reifsnyderb/Atari-1090XL-R10/1090.kicad_pcb

## KiCad design 1090.kicad_pcb (2024-02-07)

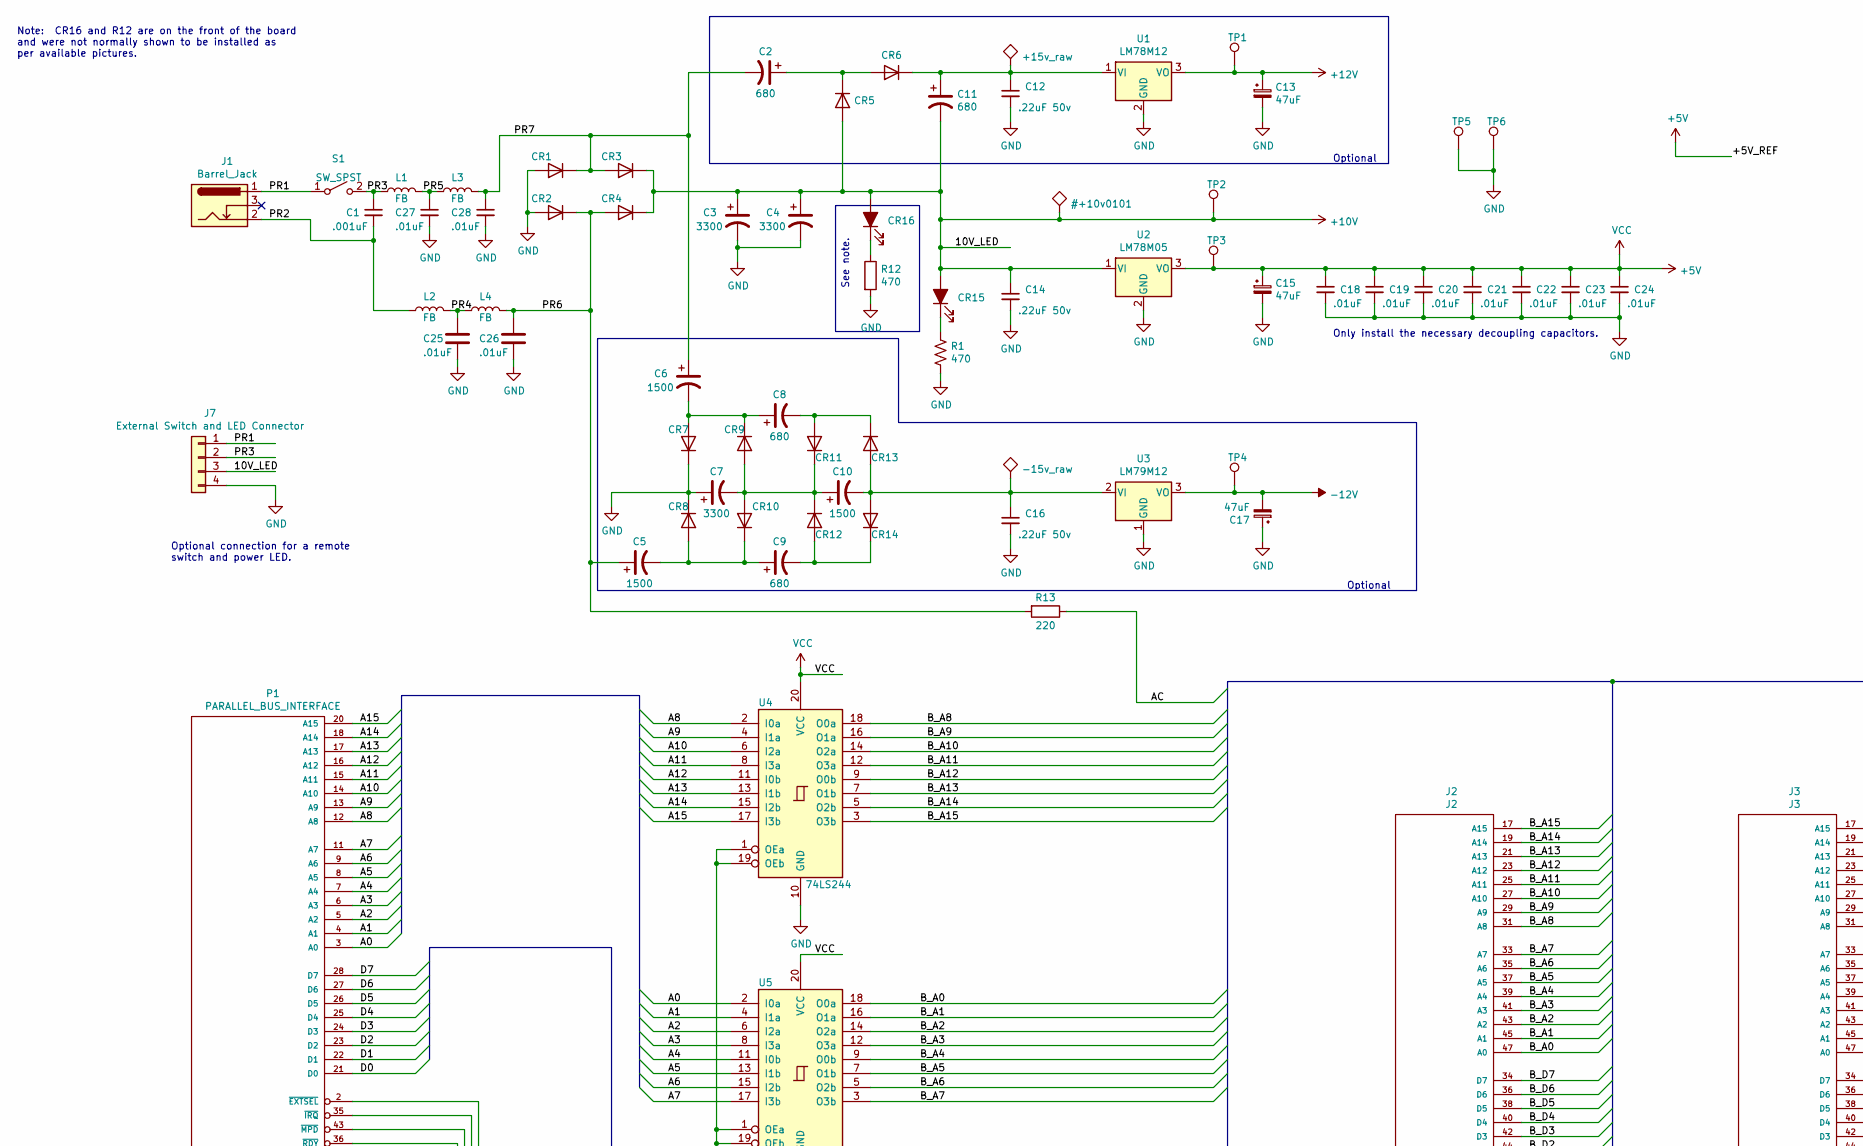
[picture p1: schematic 1090.kicad_sch, 1090 original, part in row 1, column 1]

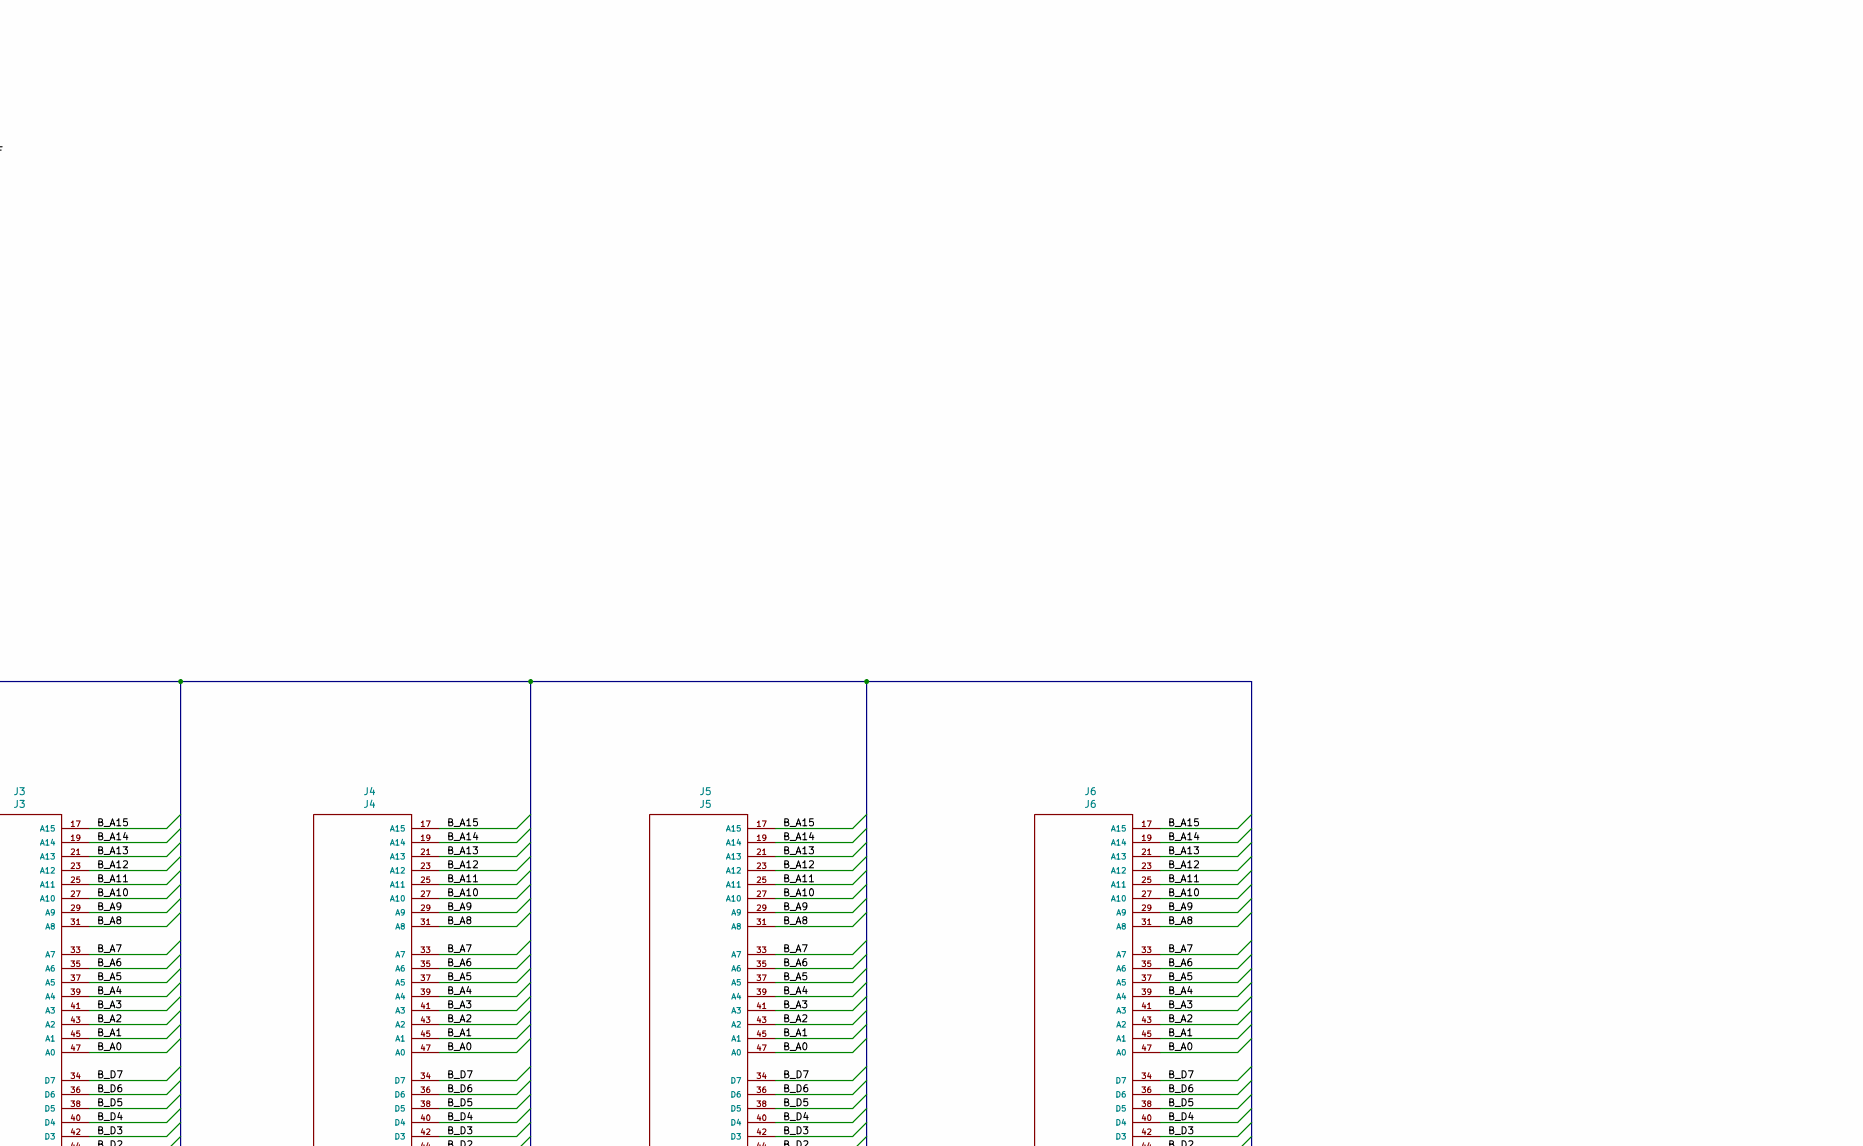
[picture p2: schematic 1090.kicad_sch, 1090 original, part in row 1, column 2]

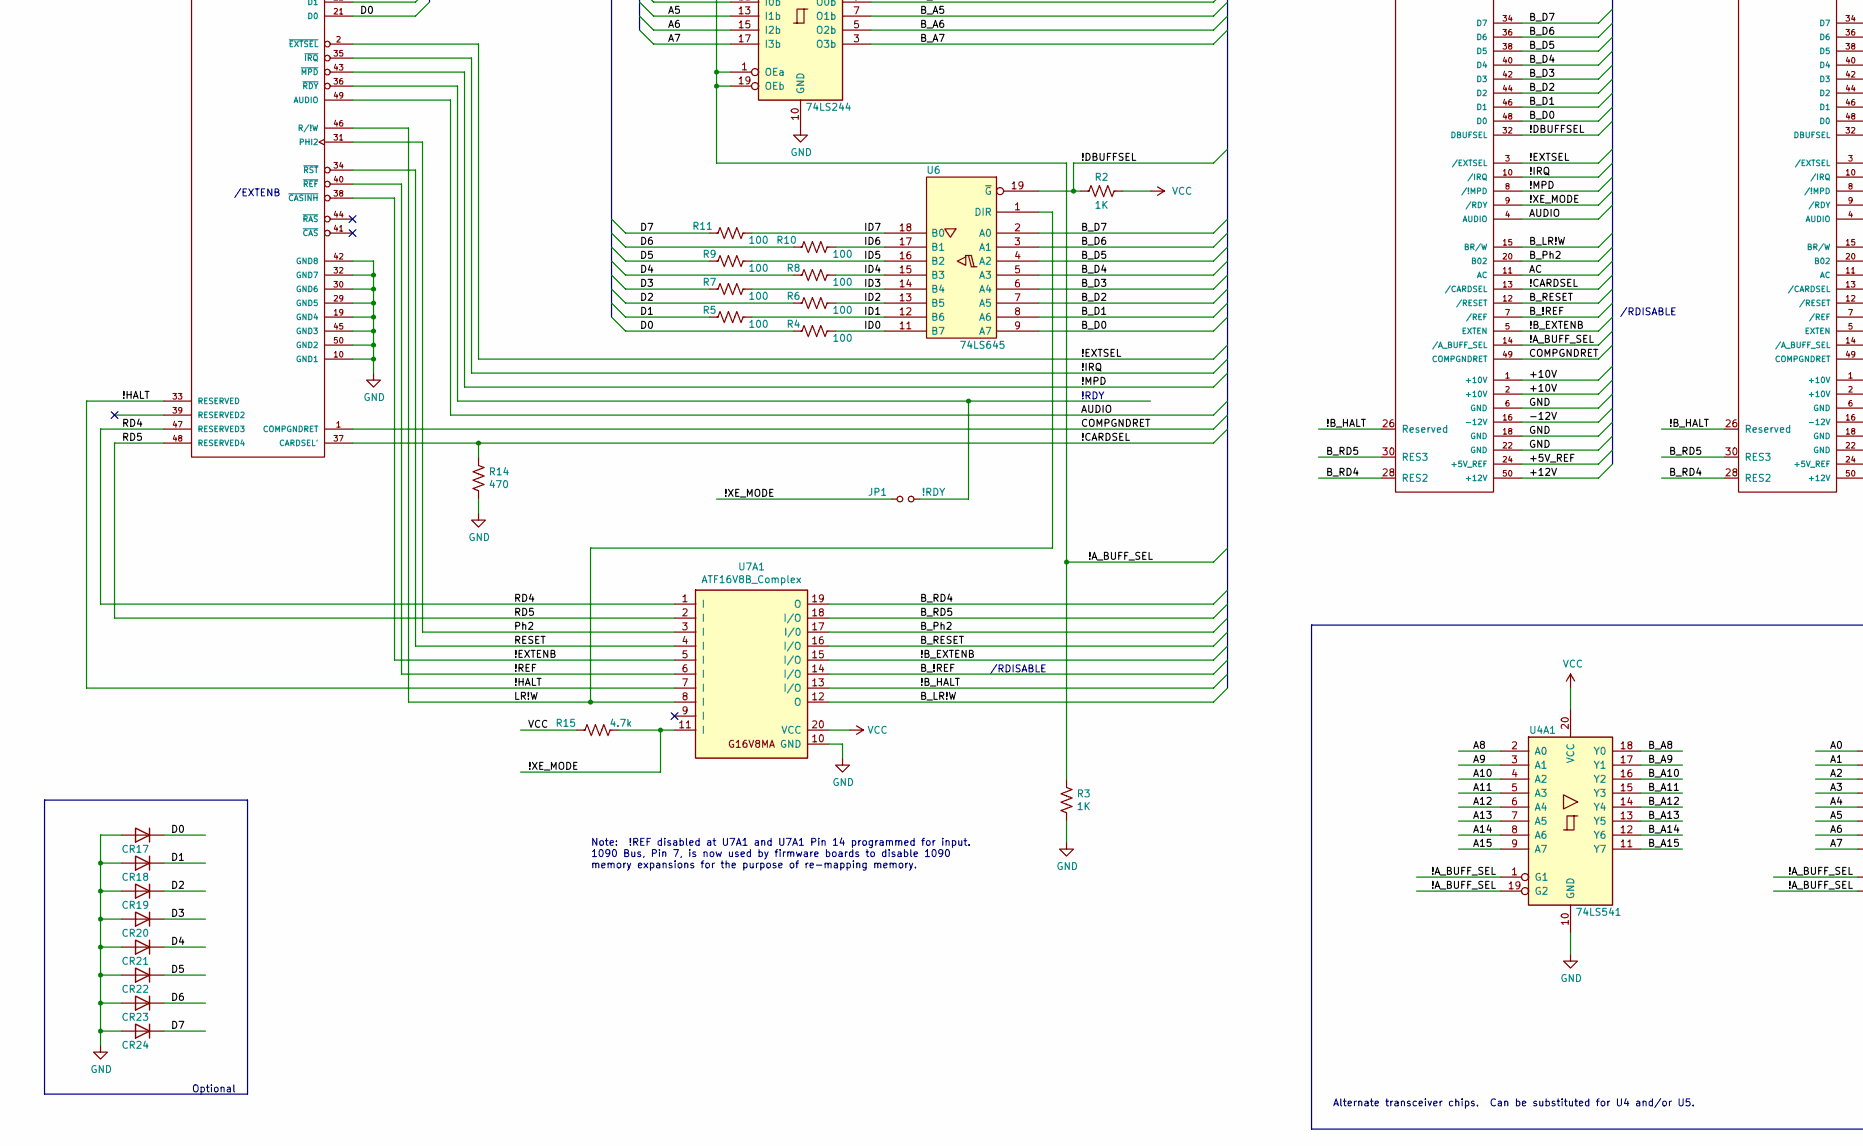
[picture p3: schematic 1090.kicad_sch, 1090 original, part in row 2, column 1]

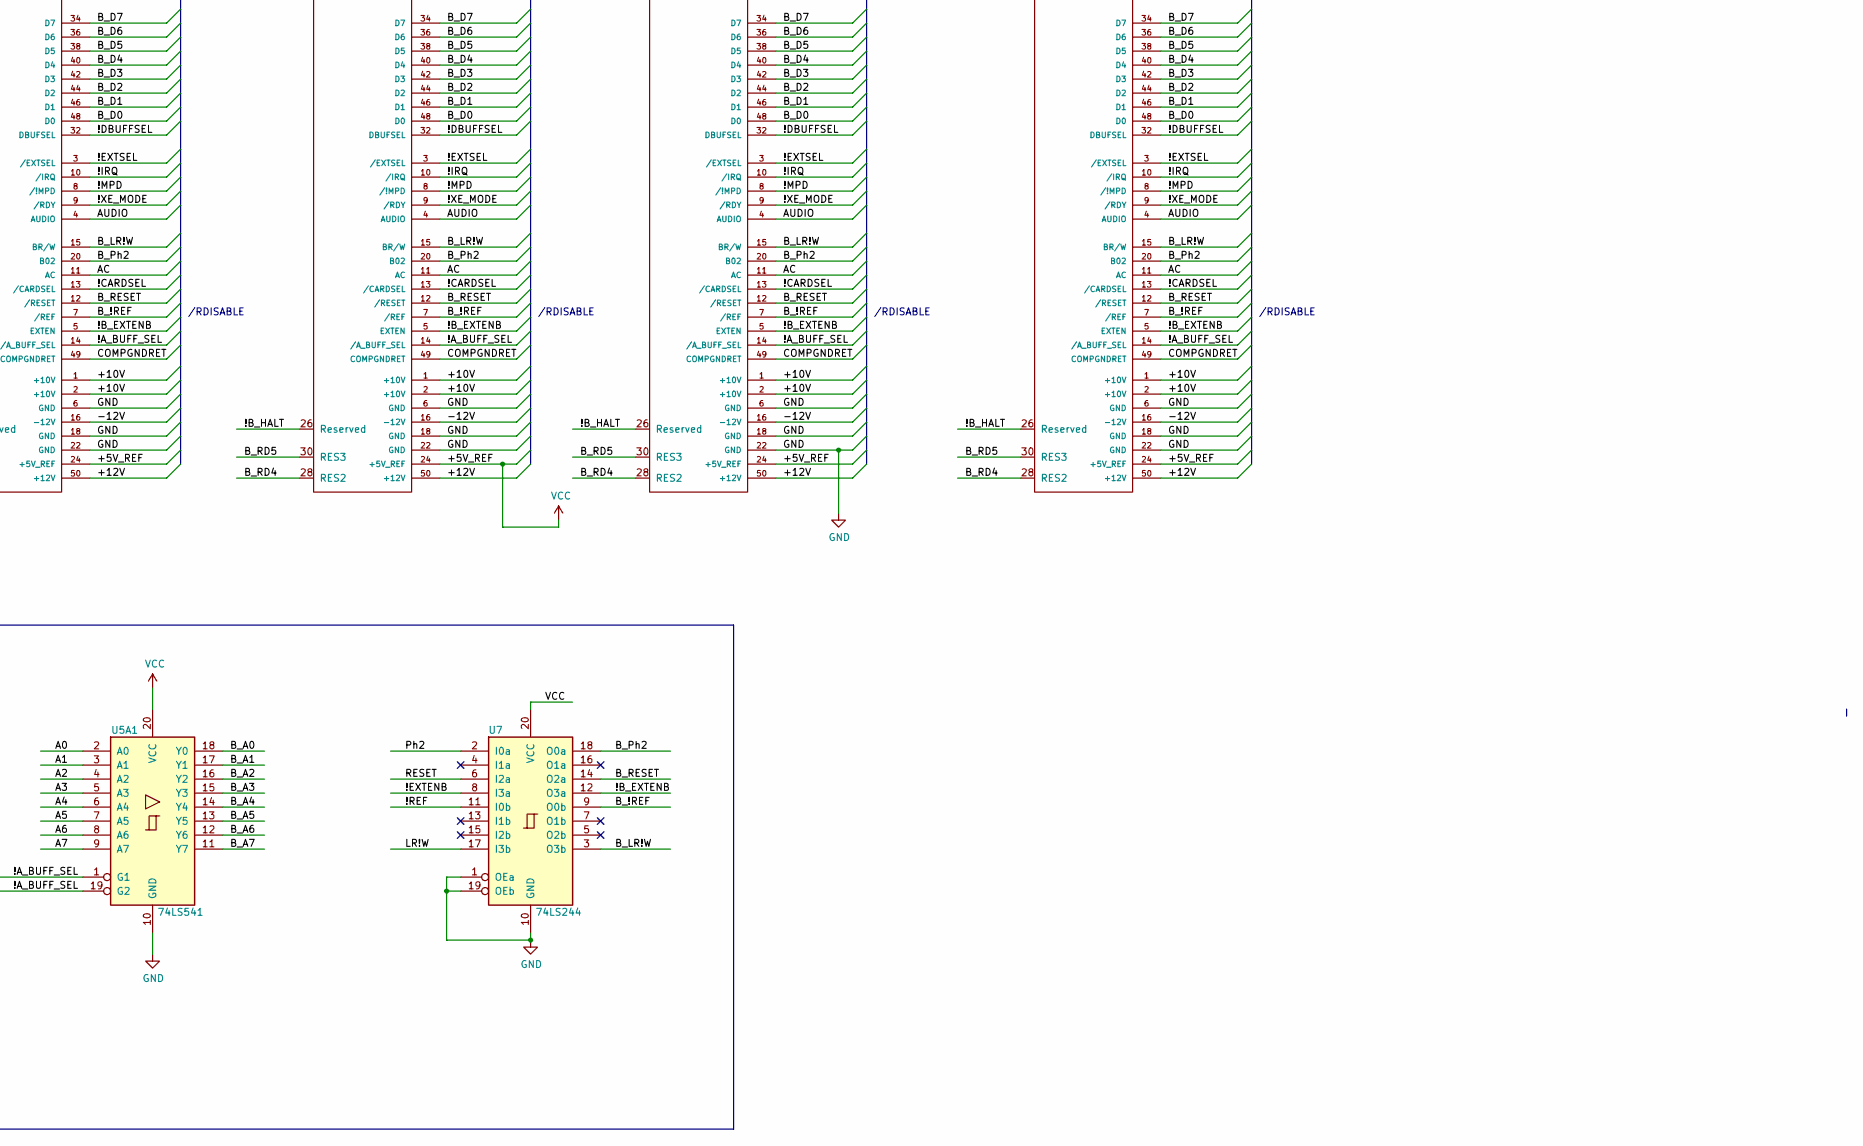
[picture p4: schematic 1090.kicad_sch, 1090 original, part in row 2, column 2]

Parts:
C1: .001uF; C_Axial_L5.1mm_D3.1mm_P12.50mm_Horizontal
C2, C8, C9, C11: 680; CP_Radial_D12.5mm_P5.00mm
C3, C4, C7: 3300; CP_Radial_D22.0mm_P7.50_10.00mm_SnapIn
C5, C6: 1500; CP_Radial_D13.0mm_P7.50mm
C10: 1500; CP_Radial_D16.0mm_P7.50mm
C12, C14: .22uF 50v; C_Axial_L5.1mm_D3.1mm_P15.00mm_Horizontal
C13, C15, C17: 47uF; CP_Radial_D8.0mm_P2.50mm
C16: .22uF 50v; C_Axial_L5.1mm_D3.1mm_P12.50mm_Horizontal
C18, C19, C20, C21, C22, C23, C24, C25, C26, C27, C28: .01uF; C_Axial_L5.1mm_D3.1mm_P12.50mm_Horizontal
CR1, CR2, CR3, CR4: D; D_5KP_P10.16mm_Horizontal
CR5, CR6, CR7, CR8, CR9, CR10, CR11, CR12, CR13, CR14, CR17, CR18, CR19, CR20, CR21, CR22, CR23, CR24: D; D_Axial_L5.1mm_D3.1mm_P12.50mm_Horizontal
CR15, CR16: LED_ALT; LED_D5.0mm_FlatTop
J1: Barrel_Jack; BarrelJack_Wuerth_6941xx301002
J2: J2; AtariSocket_2x25_P2.54mm_Vertical
J3: J3; AtariSocket_2x25_P2.54mm_Vertical
J4: J4; AtariSocket_2x25_P2.54mm_Vertical
J5: J5; AtariSocket_2x25_P2.54mm_Vertical
J6: J6; AtariSocket_2x25_P2.54mm_Vertical
J7: External Switch and LED Connector; Molex_KK-396_A-41791-0004_1x04_P3.96mm_Vertical
JP1: !RDY; PinHeader_1x02_P2.54mm_Vertical
L1, L2, L3, L4: FB; L_Axial_L5.1mm_D3.1mm_P12.50mm_Horizontal
P1: PARALLEL_BUS_INTERFACE; Edge-50
R1, R12, R14: 470; R_Axial_L5.1mm_D3.1mm_P12.50mm_Horizontal
R2, R3: 1K; R_Axial_L5.1mm_D3.1mm_P12.50mm_Horizontal
R4, R5, R6, R7, R8, R9, R10, R11: 100; R_Axial_L5.1mm_D3.1mm_P12.50mm_Horizontal
R13: 220; R_Axial_L5.1mm_D3.1mm_P12.50mm_Horizontal
R15: 4.7k; R_Axial_L5.1mm_D3.1mm_P12.50mm_Horizontal
S1: SW_SPST; E101J1ABE2; Part # E101J1AQE2
TP1: +12V; Pin_D1.0mm_L10.0mm
TP2: +10V; Pin_D1.0mm_L10.0mm
TP3: TestPoint; Pin_D1.0mm_L10.0mm
TP4: -12V; Pin_D1.0mm_L10.0mm
TP5, TP6: GND; Pin_D1.0mm_L10.0mm
U1: LM78M12; TO-220-3_Vertical
U2: LM78M05; TO-220-3_Vertical
U3: LM79M12; TO-220-3_Vertical
U4, U5, U7: 74LS244; DIP-20_W7.62mm_Socket
U4A1, U5A1: 74LS541; DIP-20_W7.62mm_Socket
U6: 74LS645; DIP-20_W7.62mm_Socket
U7A1: ATF16V8B_Complex; DIP-20_W7.62mm_Socket

Connections:
+5V: C15.1, C18.1, C19.1, C20.1, C21.1, C22.1, C23.1, C24.1, J2.24 (+5V_REF), J3.24 (+5V_REF), J4.24 (+5V_REF), J5.24 (+5V_REF), J6.24 (+5V_REF), R2.1, R15.1, TP3.1, U2.3 (VO), U4.20 (VCC), U4A1.20 (VCC), U5.20 (VCC), U5A1.20 (VCC), U6.20 (VCC), U7.20 (VCC), U7A1.20 (VCC)
+10V: C3.1, C4.1, C11.2, C14.1, CR3.1 (K), CR4.1 (K), CR5.2 (A), CR15.2 (A), CR16.2 (A), J2.1 (+10V), J2.2 (+10V), J3.1 (+10V), J3.2 (+10V), J4.1 (+10V), J4.2 (+10V), J5.1 (+10V), J5.2 (+10V), J6.1 (+10V), J6.2 (+10V), J7.3, TP2.1, U2.1 (VI)
+12V: C13.1, J2.50 (+12V), J3.50 (+12V), J4.50 (+12V), J5.50 (+12V), J6.50 (+12V), TP1.1, U1.3 (VO)
-12V: C17.2, J2.16 (-12V), J3.16 (-12V), J4.16 (-12V), J5.16 (-12V), J6.16 (-12V), TP4.1, U3.3 (VO)
/!A_BUFF_SEL: J2.14 (/A_BUFF_SEL), J3.14 (/A_BUFF_SEL), J4.14 (/A_BUFF_SEL), J5.14 (/A_BUFF_SEL), J6.14 (/A_BUFF_SEL), R3.1, U4.1 (OEa), U4.19 (OEb), U4A1.1 (G1), U4A1.19 (G2), U5.1 (OEa), U5.19 (OEb), U5A1.1 (G1), U5A1.19 (G2)
/!B_EXTENB: J2.5 (EXTEN), J3.5 (EXTEN), J4.5 (EXTEN), J5.5 (EXTEN), J6.5 (EXTEN), U7.12 (O3a), U7A1.15 (I/O)
/!B_HALT: J2.26 (Reserved), J3.26 (Reserved), J4.26 (Reserved), J5.26 (Reserved), J6.26 (Reserved), U7A1.13 (I/O)
/!CARDSEL: J2.13 (/CARDSEL), J3.13 (/CARDSEL), J4.13 (/CARDSEL), J5.13 (/CARDSEL), J6.13 (/CARDSEL), P1.37 (CARDSEL'), R14.1
/!DBUFFSEL: J2.32 (DBUFSEL), J3.32 (DBUFSEL), J4.32 (DBUFSEL), J5.32 (DBUFSEL), J6.32 (DBUFSEL), R2.2, U6.19 (~G)
/!EXTENB: P1.38 (~CASINH), U7.8 (I3a), U7A1.5 (I)
/!EXTSEL: J2.3 (/EXTSEL), J3.3 (/EXTSEL), J4.3 (/EXTSEL), J5.3 (/EXTSEL), J6.3 (/EXTSEL), P1.2 (~EXTSEL)
/!HALT: P1.33 (RESERVED), U7A1.7 (I)
/!IRQ: J2.10 (/IRQ), J3.10 (/IRQ), J4.10 (/IRQ), J5.10 (/IRQ), J6.10 (/IRQ), P1.35 (~IRQ)
/!MPD: J2.8 (/!MPD), J3.8 (/!MPD), J4.8 (/!MPD), J5.8 (/!MPD), J6.8 (/!MPD), P1.43 (~MPD)
/!REF: P1.40 (~REF), U7.11 (I0b), U7A1.6 (I)
/!XE_MODE: J2.9 (/RDY), J3.9 (/RDY), J4.9 (/RDY), J5.9 (/RDY), J6.9 (/RDY), JP1.1, R15.2, U7A1.11 (I)
/A0: P1.3 (A0), U5.2 (I0a), U5A1.2 (A0)
/A1: P1.4 (A1), U5.4 (I1a), U5A1.3 (A1)
/A2: P1.5 (A2), U5.6 (I2a), U5A1.4 (A2)
/A3: P1.6 (A3), U5.8 (I3a), U5A1.5 (A3)
/A4: P1.7 (A4), U5.11 (I0b), U5A1.6 (A4)
/A5: P1.8 (A5), U5.13 (I1b), U5A1.7 (A5)
/A6: P1.9 (A6), U5.15 (I2b), U5A1.8 (A6)
/A7: P1.11 (A7), U5.17 (I3b), U5A1.9 (A7)
/A8: P1.12 (A8), U4.2 (I0a), U4A1.2 (A0)
/A9: P1.13 (A9), U4.4 (I1a), U4A1.3 (A1)
/A10: P1.14 (A10), U4.6 (I2a), U4A1.4 (A2)
/A11: P1.15 (A11), U4.8 (I3a), U4A1.5 (A3)
/A12: P1.16 (A12), U4.11 (I0b), U4A1.6 (A4)
/A13: P1.17 (A13), U4.13 (I1b), U4A1.7 (A5)
/A14: P1.18 (A14), U4.15 (I2b), U4A1.8 (A6)
/A15: P1.20 (A15), U4.17 (I3b), U4A1.9 (A7)
/AC: J2.11 (AC), J3.11 (AC), J4.11 (AC), J5.11 (AC), J6.11 (AC), R13.1
/AUDIO: J2.4 (AUDIO), J3.4 (AUDIO), J4.4 (AUDIO), J5.4 (AUDIO), J6.4 (AUDIO), P1.49 (AUDIO)
/B_!REF: J2.7 (/REF), J3.7 (/REF), J4.7 (/REF), J5.7 (/REF), J6.7 (/REF), U7.9 (O0b), U7A1.14 (I/O)
/B_A0: J2.47 (A0), J3.47 (A0), J4.47 (A0), J5.47 (A0), J6.47 (A0), U5.18 (O0a), U5A1.18 (Y0)
/B_A1: J2.45 (A1), J3.45 (A1), J4.45 (A1), J5.45 (A1), J6.45 (A1), U5.16 (O1a), U5A1.17 (Y1)
/B_A2: J2.43 (A2), J3.43 (A2), J4.43 (A2), J5.43 (A2), J6.43 (A2), U5.14 (O2a), U5A1.16 (Y2)
/B_A3: J2.41 (A3), J3.41 (A3), J4.41 (A3), J5.41 (A3), J6.41 (A3), U5.12 (O3a), U5A1.15 (Y3)
/B_A4: J2.39 (A4), J3.39 (A4), J4.39 (A4), J5.39 (A4), J6.39 (A4), U5.9 (O0b), U5A1.14 (Y4)
/B_A5: J2.37 (A5), J3.37 (A5), J4.37 (A5), J5.37 (A5), J6.37 (A5), U5.7 (O1b), U5A1.13 (Y5)
/B_A6: J2.35 (A6), J3.35 (A6), J4.35 (A6), J5.35 (A6), J6.35 (A6), U5.5 (O2b), U5A1.12 (Y6)
/B_A7: J2.33 (A7), J3.33 (A7), J4.33 (A7), J5.33 (A7), J6.33 (A7), U5.3 (O3b), U5A1.11 (Y7)
/B_A8: J2.31 (A8), J3.31 (A8), J4.31 (A8), J5.31 (A8), J6.31 (A8), U4.18 (O0a), U4A1.18 (Y0)
/B_A9: J2.29 (A9), J3.29 (A9), J4.29 (A9), J5.29 (A9), J6.29 (A9), U4.16 (O1a), U4A1.17 (Y1)
/B_A10: J2.27 (A10), J3.27 (A10), J4.27 (A10), J5.27 (A10), J6.27 (A10), U4.14 (O2a), U4A1.16 (Y2)
/B_A11: J2.25 (A11), J3.25 (A11), J4.25 (A11), J5.25 (A11), J6.25 (A11), U4.12 (O3a), U4A1.15 (Y3)
/B_A12: J2.23 (A12), J3.23 (A12), J4.23 (A12), J5.23 (A12), J6.23 (A12), U4.9 (O0b), U4A1.14 (Y4)
/B_A13: J2.21 (A13), J3.21 (A13), J4.21 (A13), J5.21 (A13), J6.21 (A13), U4.7 (O1b), U4A1.13 (Y5)
/B_A14: J2.19 (A14), J3.19 (A14), J4.19 (A14), J5.19 (A14), J6.19 (A14), U4.5 (O2b), U4A1.12 (Y6)
/B_A15: J2.17 (A15), J3.17 (A15), J4.17 (A15), J5.17 (A15), J6.17 (A15), U4.3 (O3b), U4A1.11 (Y7)
/B_D0: J2.48 (D0), J3.48 (D0), J4.48 (D0), J5.48 (D0), J6.48 (D0), U6.9 (A7)
/B_D1: J2.46 (D1), J3.46 (D1), J4.46 (D1), J5.46 (D1), J6.46 (D1), U6.8 (A6)
/B_D2: J2.44 (D2), J3.44 (D2), J4.44 (D2), J5.44 (D2), J6.44 (D2), U6.7 (A5)
/B_D3: J2.42 (D3), J3.42 (D3), J4.42 (D3), J5.42 (D3), J6.42 (D3), U6.6 (A4)
/B_D4: J2.40 (D4), J3.40 (D4), J4.40 (D4), J5.40 (D4), J6.40 (D4), U6.5 (A3)
/B_D5: J2.38 (D5), J3.38 (D5), J4.38 (D5), J5.38 (D5), J6.38 (D5), U6.4 (A2)
/B_D6: J2.36 (D6), J3.36 (D6), J4.36 (D6), J5.36 (D6), J6.36 (D6), U6.3 (A1)
/B_D7: J2.34 (D7), J3.34 (D7), J4.34 (D7), J5.34 (D7), J6.34 (D7), U6.2 (A0)
/B_LR!W: J2.15 (BR/W), J3.15 (BR/W), J4.15 (BR/W), J5.15 (BR/W), J6.15 (BR/W), U7.3 (O3b), U7A1.12 (O)
/B_Ph2: J2.20 (B02), J3.20 (B02), J4.20 (B02), J5.20 (B02), J6.20 (B02), U7.18 (O0a), U7A1.17 (I/0)
/B_RD4: J2.28 (RES2), J3.28 (RES2), J4.28 (RES2), J5.28 (RES2), J6.28 (RES2), U7A1.19 (O)
/B_RD5: J2.30 (RES3), J3.30 (RES3), J4.30 (RES3), J5.30 (RES3), J6.30 (RES3), U7A1.18 (I/O)
/B_RESET: J2.12 (/RESET), J3.12 (/RESET), J4.12 (/RESET), J5.12 (/RESET), J6.12 (/RESET), U7.14 (O2a), U7A1.16 (I/O)
/COMPGNDRET: J2.49 (COMPGNDRET), J3.49 (COMPGNDRET), J4.49 (COMPGNDRET), J5.49 (COMPGNDRET), J6.49 (COMPGNDRET), P1.1 (COMPGNDRET)
/D0: CR17.1 (K), P1.21 (D0), R4.2
/D1: CR18.1 (K), P1.22 (D1), R5.2
/D2: CR19.1 (K), P1.23 (D2), R6.2
/D3: CR20.1 (K), P1.24 (D3), R7.2
/D4: CR21.1 (K), P1.25 (D4), R8.2
/D5: CR22.1 (K), P1.26 (D5), R9.2
/D6: CR23.1 (K), P1.27 (D6), R10.2
/D7: CR24.1 (K), P1.28 (D7), R11.2
/ID0: R4.1, U6.11 (B7)
/ID1: R5.1, U6.12 (B6)
/ID2: R6.1, U6.13 (B5)
/ID3: R7.1, U6.14 (B4)
/ID4: R8.1, U6.15 (B3)
/ID5: R9.1, U6.16 (B2)
/ID6: R10.1, U6.17 (B1)
/ID7: R11.1, U6.18 (B0)
/LR!W: P1.46 (R/!W), U6.1 (DIR), U7.17 (I3b), U7A1.8 (I)
/PR1: J1.1, J7.1, S1.1 (A)
/PR2: C1.2, J1.2, L2.1
/PR3: C1.1, J7.2, L1.1, S1.2 (B)
/PR4: C25.1, L2.2, L4.1
/PR5: C27.1, L1.2, L3.1
/PR6: C5.1, C26.1, CR2.1 (K), CR4.2 (A), L4.2, R13.2
/PR7: C2.2, C6.1, C28.1, CR1.1 (K), CR3.2 (A), L3.2
/Ph2: P1.31 (PHI2), U7.2 (I0a), U7A1.3 (I)
/RD4: P1.47 (RESERVED3), U7A1.1 (I)
/RD5: P1.48 (RESERVED4), U7A1.2 (I)
/RESET: P1.34 (~RST), U7.6 (I2a), U7A1.4 (I)
GND: C3.2, C4.2, C7.1, C12.2, C13.2, C14.2, C15.2, C16.2, C17.1, C18.2, C19.2, C20.2, C21.2, C22.2, C23.2, C24.2, C25.2, C26.2, C27.2, C28.2, CR1.2 (A), CR2.2 (A), CR7.1 (K), CR8.1 (K), CR17.2 (A), CR18.2 (A), CR19.2 (A), CR20.2 (A), CR21.2 (A), CR22.2 (A), CR23.2 (A), CR24.2 (A), J2.6 (GND), J2.18 (GND), J2.22 (GND), J3.6 (GND), J3.18 (GND), J3.22 (GND), J4.6 (GND), J4.18 (GND), J4.22 (GND), J5.6 (GND), J5.18 (GND), J5.22 (GND), J6.6 (GND), J6.18 (GND), J6.22 (GND), J7.4, P1.10 (GND1), P1.19 (GND4), P1.29 (GND5), P1.30 (GND6), P1.32 (GND7), P1.42 (GND8), P1.45 (GND3), P1.50 (GND2), R1.2, R3.2, R12.2, R14.2, TP5.1, TP6.1, U1.2 (GND), U2.2 (GND), U3.1 (GND), U4.10 (GND), U4A1.10 (GND), U5.10 (GND), U5A1.10 (GND), U6.10 (GND), U7.1 (OEa), U7.10 (GND), U7.19 (OEb), U7A1.10 (GND)
unnamed: C2.1, CR5.1 (K), CR6.2 (A)
unnamed: C5.2, C9.1, CR8.2 (A), CR10.1 (K)
unnamed: C6.2, C8.1, CR7.2 (A), CR9.1 (K)
unnamed: C8.2, CR11.2 (A), CR13.1 (K)
unnamed: C9.2, CR12.2 (A), CR14.1 (K)
unnamed: C7.2, C10.1, CR9.2 (A), CR10.2 (A), CR11.1 (K), CR12.1 (K)
unnamed: C10.2, C16.1, CR13.2 (A), CR14.2 (A), U3.2 (VI)
unnamed: C11.1, C12.1, CR6.1 (K), U1.1 (VI)
unnamed: CR15.1 (K), R1.1
unnamed: CR16.1 (K), R12.1
unnamed: JP1.2, P1.36 (~RDY)

Notes on the sheet:
Optional
/RDISABLE
Note: CR16 and R12 are on the front of the board and were not normally shown to be installed as per available pictures.
!RDY
Note: !REF disabled at U7A1 and U7A1 Pin 14 programmed for input. 1090 Bus, Pin 7, is now used by firmware boards to disable 1090 memory expansions for the purpose of re-mapping memory.
Only install the necessary decoupling capacitors.
Optional connection for a remote switch and power LED.
/EXTENB
Alternate transceiver chips. Can be substituted for U4 and/or U5.
See note.

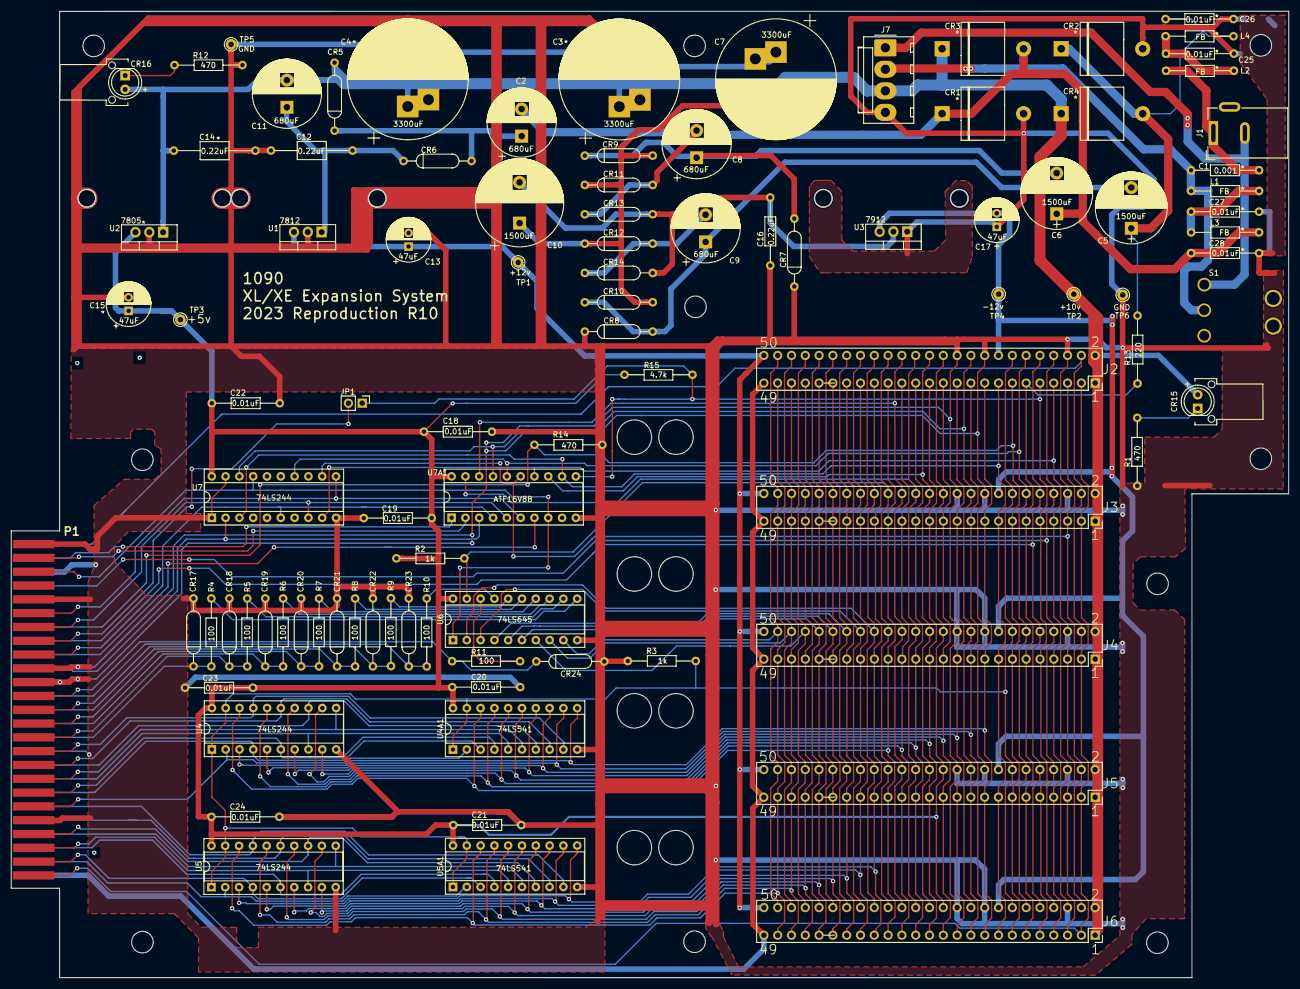
[picture p5: board 1090.kicad_pcb from above]

Board: 2 copper layers, 235.1 x 177.8 mm, 97 parts (1 on the bottom side), 105 nets.
